MarkoMuc/kicad-riscv-workshop/fab/FRI-ESP32-BOM.csv

Reference | Qty | Value | DNP | Exclude from BOM | Exclude from Board | Footprint | Datasheet | Purpose | Description | # | LCSC | MPN
BOOT1,RESET2,USERBUTTON1 | 3 | SW_Push |  |  |  | fri:SW_SPST_B3U-1000P-B |  |  | Push button switch, generic, two pins | 1 | C231329 | B3U-1000P
C1,C4 | 2 | 10uF |  |  |  | Capacitor_SMD:C_0805_2012Metric |  |  | Unpolarized capacitor | 2
C2 | 1 | 4.7uF |  |  |  | Capacitor_SMD:C_0805_2012Metric |  |  | Unpolarized capacitor | 3
C3,C5,C6,C7 | 4 | 100nF |  |  |  | Capacitor_SMD:C_0402_1005Metric |  |  | Unpolarized capacitor | 4
D1 | 1 | PESD5V0S1UL |  |  |  | Diode_SMD:D_SOD-882 | https://assets.nexperia.com/documents/data-sheet/PESD5V0S1UL.pdf |  | Unidirectional ESD protection diode, 5V, SOD-882 | 5
D2 | 1 | LED YELLOW |  |  |  | LED_SMD:LED_0805_2012Metric |  |  | Light emitting diode | 6 | C2297
D3 | 1 | LED GREEN |  |  |  | LED_SMD:LED_0805_2012Metric |  |  | Light emitting diode | 7 | C2297
J1 | 1 | USB_C_Receptacle_USB2.0_16P |  |  |  | fri:USB_C_Receptacle_G-Switch_GT-USB-7010ASV | https://www.usb.org/sites/default/files/documents/usb_type-c.zip |  | USB 2.0-only 16P Type-C Receptacle connector | 8 | C2988369 | GT-USB-7010ASV
R1,R2 | 2 | 5.1K |  |  |  | Resistor_SMD:R_0402_1005Metric |  |  | Resistor | 9
R3,R6,R7,R8,R9,R10 | 6 | 10K |  |  |  | Resistor_SMD:R_0402_1005Metric |  |  | Resistor | 10
R4,R5 | 2 | 330 |  |  |  | Resistor_SMD:R_0402_1005Metric |  |  | Resistor | 11
U1 | 1 | USBLC6-2SC6 |  |  |  | fri:SOT-23-6 | https://www.st.com/resource/en/datasheet/usblc6-2.pdf |  | Very low capacitance ESD protection diode, 2 data-line, SOT-23-6 | 12 | C7519
U2 | 1 | XC6220B331MR |  |  |  | fri:SOT-23-5 | https://www.torexsemi.com/file/xc6220/XC6220.pdf |  | 1A, Low Drop-out Voltage Regulator, Fixed Output 3.3V, SOT-23-5 | 13
U3 | 1 | ESP32-C3-MINI-1 |  |  |  | fri:ESP32-C3-MINI-1 | https://www.espressif.com/sites/default/files/documentation/esp32-c3-mini-1_datasheet_en.pdf |  | ESP32-C3-MINI-1 family is an ultra-low-power MCU-based SoC solution that supports 2.4 GHz Wi-Fi and Bluetooth®Low Energy (Bluetooth LE). | 14 | C2838502 | ESP32-C3-MINI-1-N4
